todbot/sketchingpad/docs/planning.md

# sketchingpad_stripproto1

## pad layout from top

```
     17 18      19 20
 1  2  3  4    5  6  7  8
 9 10 11 12   13 14 15 16
 ```
 
 - flipped on horizontal axis (e.g. 1 & 9 mirrored)
 - dX = 18 mm
 - dY = 19 mm
 - midXfudge = 4mm (say)
 => `maxX = 4*dX + midXfudge = 4*18 + 10 = 82` 
 =>  22,40,58,76 for one side

## size
 180 mm x 62.4 mm   (7.1" x 2.5")  
 but want 6" (152mm, half = 152/2 = 76 mm

# NRF52840 links

- https://github.com/joric/nrfmicro/wiki/Alternatives
- https://github.com/joric/nrfmicro/wiki/Bootloader
- https://github.com/abulalarabi/NRF52-BRICKED
- https://docs.zephyrproject.org/latest/boards/others/promicro_nrf52840/doc/index.html
- https://nicekeyboards.com/docs/nice-nano/troubleshooting/
