todbot/sketchingpad/docs/artwork/waves-20260901-184750.png

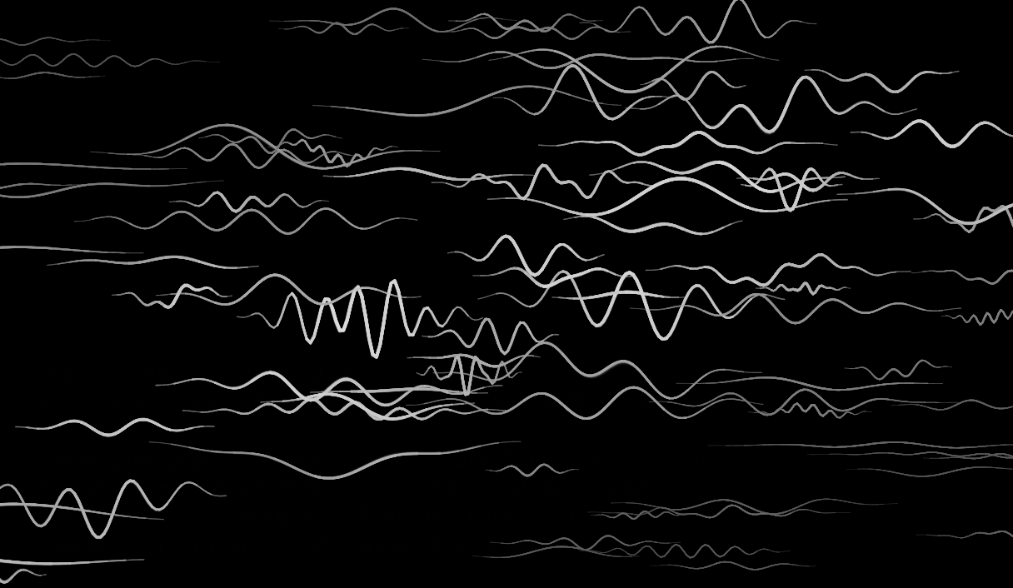
docs/artwork/waves-20260901-184750.png
