todbot/sketchingpad/docs/artwork/waves-20260901-184809.png

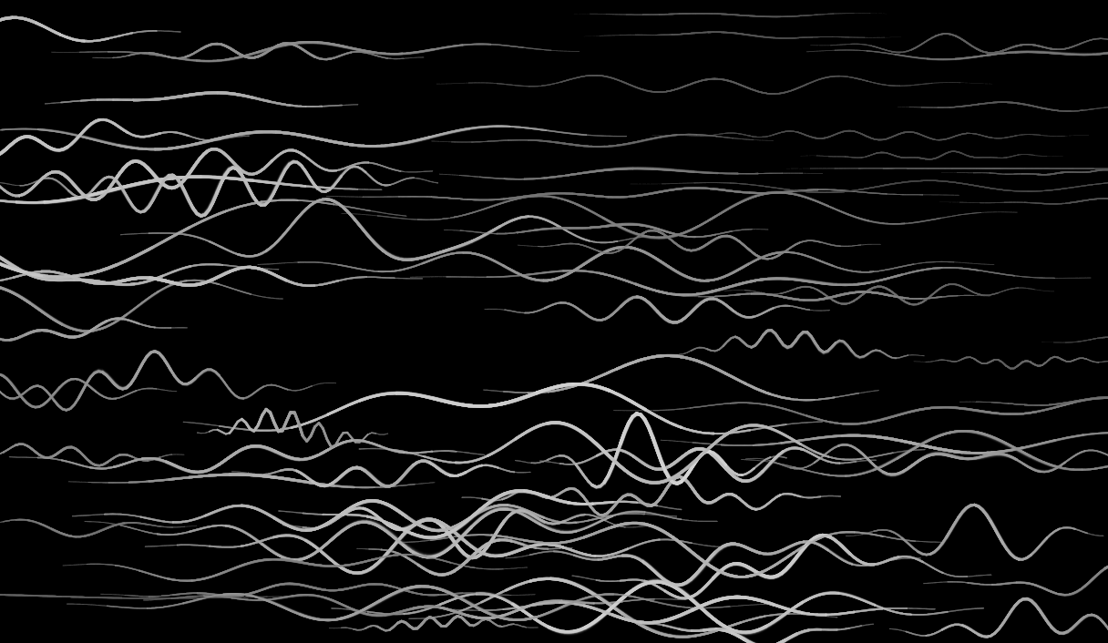
docs/artwork/waves-20260901-184809.png
