todbot/sketchingpad/docs/artwork/waves-20260901-184929.png

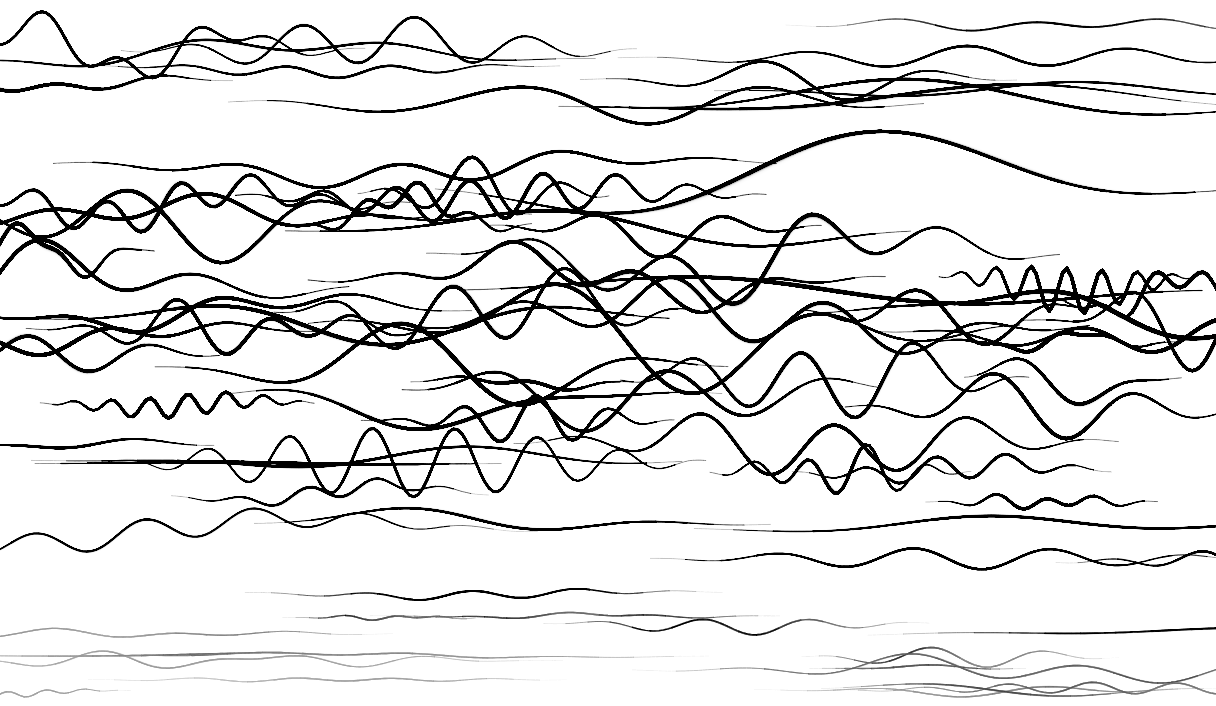
docs/artwork/waves-20260901-184929.png
