todbot/sketchingpad/docs/sketchingpad1-render.jpg

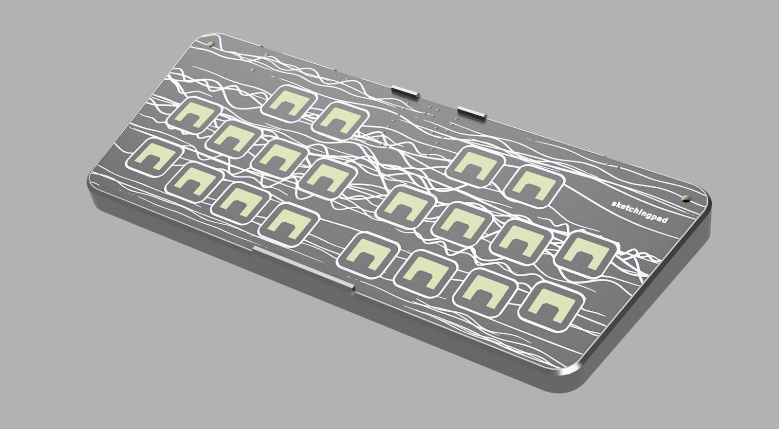
docs/sketchingpad1-render.jpg
