todbot/sketchingpad/enclosure/sketchingpad_case_soldered_sketching.stl

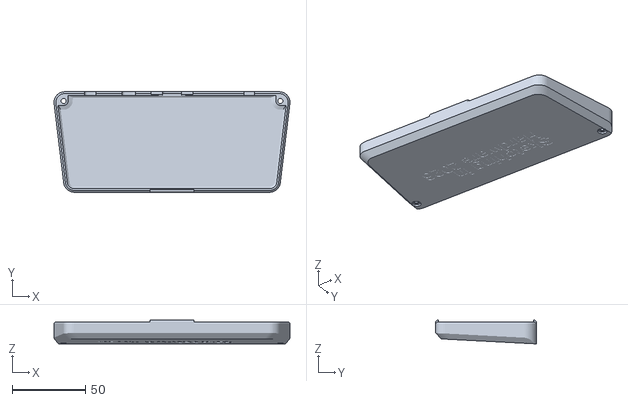
[picture p9: CAD file, 2026-10-23]
enclosure/sketchingpad_case_soldered_sketching.stl
161.1 x 68.7 x 16.2
