todbot/sketchingpad/(list of files, cad)

Other CAD files:
enclosure/sketchingpad_case_soldered.step
enclosure/sketchingpad_case_header.step
enclosure/sketchingpad_case.step
enclosure/sketchingpad_case.f3z
enclosure/sketchingpad_case_header.stl
enclosure/sketchingpad_case_soldered.stl
