todbot/sketchingpad/docs/issues.md

# Issues with sketchingpad pcb (aka sketchingpad_proto2)

- BAT+/BAT- pins cannot take the 9mm solderable pogo pins (they short)
- Instead: 50mm stranded wire pair soldered between PCB and XIAO NRF52840

# Issues with sketchingpad_proto1 pcb

- QTPy footprint flipped. omg duh
- Corner radii too small, looks weird
- Backlit LEDs do not show blue very well
