todbot/sketchingpad/schematics/sketchingpad1/sketchingpad1-sch.pdf

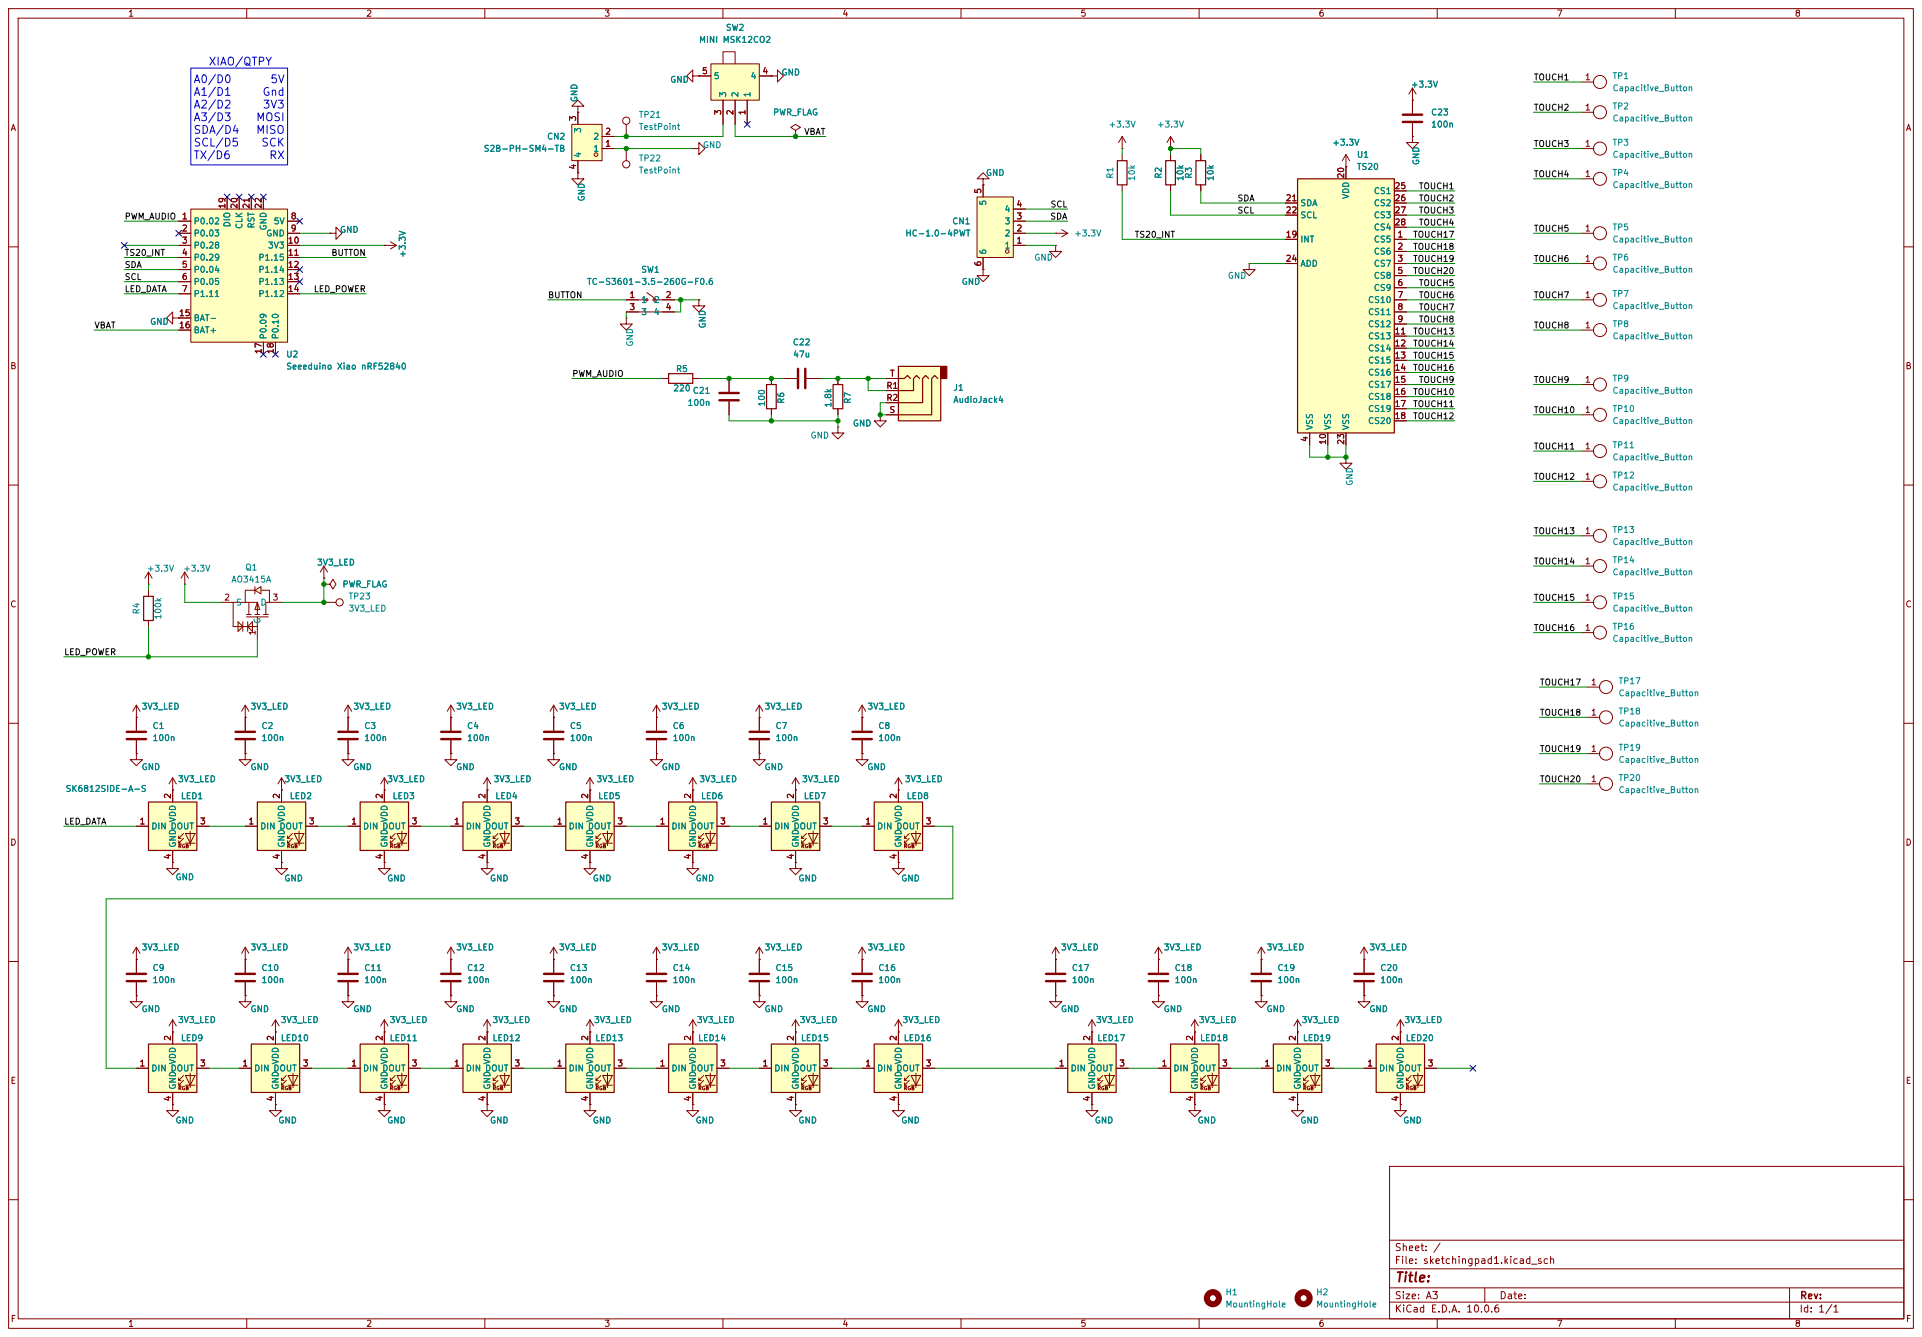
[picture p10: page 1]

Size: A3 | Rev: | F Date:
KiCad E.D.A. 10.0.6 | Id: 1/1
