todbot/sketchingpad/schematics/sketchingpad1_mpr/sketchingpad1_mpr-sch.pdf

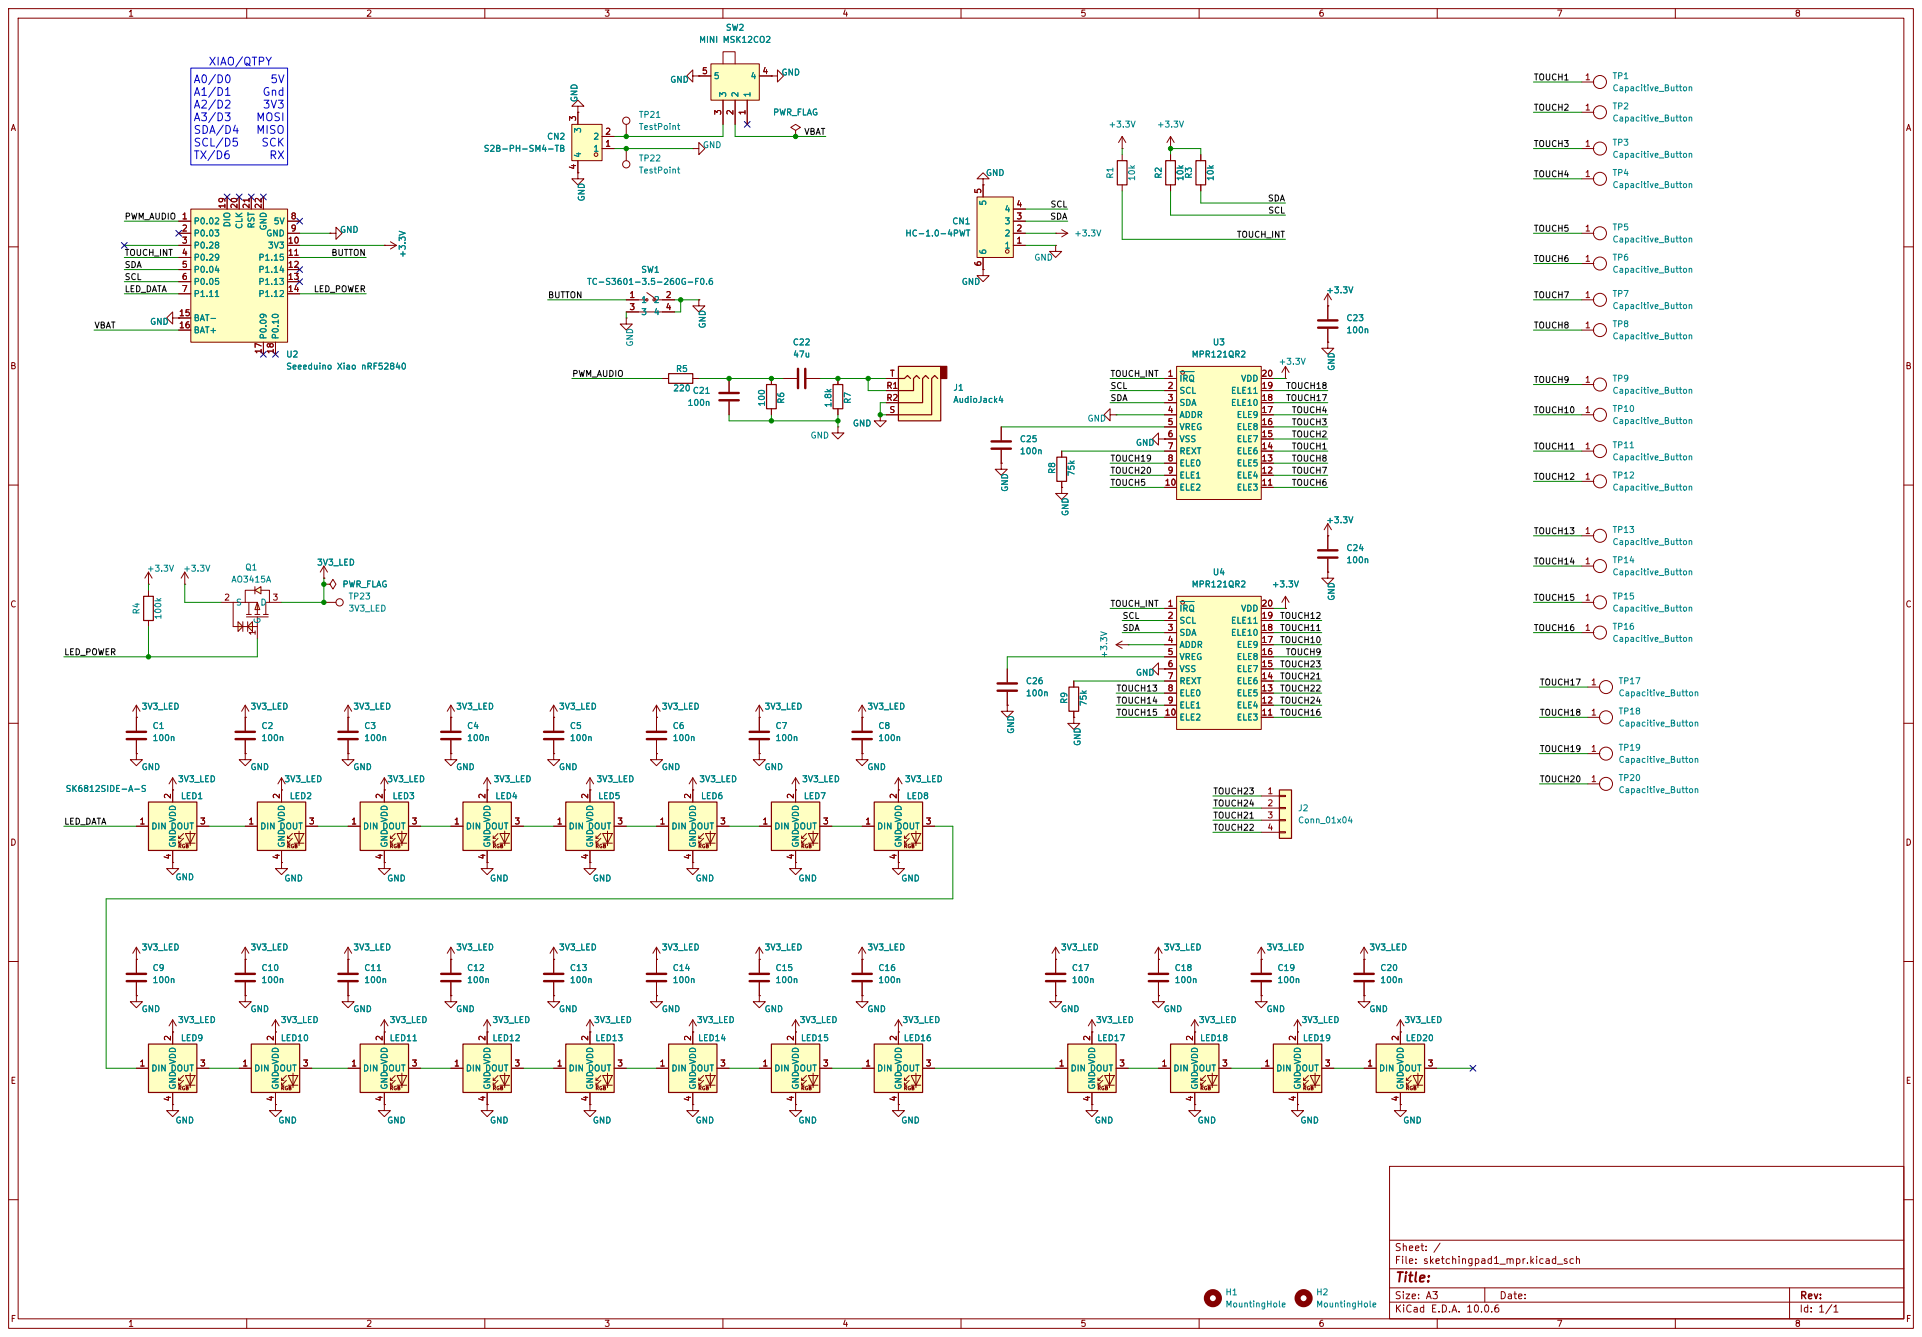
[picture p11: page 1]

Size: A3 | Rev: | F Date:
KiCad E.D.A. 10.0.6 | Id: 1/1
