todbot/sketchingpad/(commit log)

2026-07-03 some pcb layout for touch
    [leds.kicad_sch, sketchingpad.kicad_pcb, sketchingpad.kicad_sch]
2026-07-08 sketchingpad_proto1: chickening out with sk6812side instead of charlieplex RGB
    [leds.kicad_sch, sketchingpad.kicad_pcb, sketchingpad.kicad_sch, sketchingpad_proto1.kicad_pcb, sketchingpad_proto1.kicad_sch]
2026-07-09 sketchingpad_proto1: routing
    [sketchingpad_proto1.kicad_pcb]
2026-07-09 sketchingpad_proto1: routing done, no drc
    [leds.kicad_sch, sketchingpad_proto1.kicad_pcb]
2026-07-10 sketchingpad_proto1: routing cleanup, no drc
    [sketchingpad_proto1.kicad_pcb]
2026-07-20 add boost converter
    [sketchingpad_proto1.kicad_pcb, sketchingpad_proto1.kicad_sch]
2026-07-31 update boost converter parts
    [sketchingpad_proto1.kicad_pcb, sketchingpad_proto1.kicad_sch]
2026-07-31 extra input boost cap, stemmaqt/qwicc connector, added top decorative fill
    [leds.kicad_sch, sketchingpad_proto1.kicad_pcb, sketchingpad_proto1.kicad_sch]
2026-07-31 cleanup after some DRC/ERC
    [sketchingpad_proto1.kicad_pcb, sketchingpad_proto1.kicad_sch]
2026-08-25 circuitpytohn tests
2026-08-29 add stripproto1
    [sketchingpad_stripproto1.kicad_pcb, sketchingpad_stripproto1.kicad_sch]
2026-08-30 add arduino hwtest
    [sketchingpad_stripproto1.kicad_pcb, sketchingpad_stripproto1.kicad_sch]
2026-08-30 add circuitpython pwm audio test on nrf52
2026-08-30 add ble_keyboard_lowpower and start and group BLE party
    [sketchingpad_stripproto1.kicad_sch]
2026-08-30 going with SMD-mounted XIAO I guess, added audio. ERC clean
    [sketchingpad_stripproto1.kicad_pcb, sketchingpad_stripproto1.kicad_sch]
2026-08-30 final on the sketchingpad_stripproto1 sch maybe
    [sketchingpad_stripproto1.kicad_pcb, sketchingpad_stripproto1.kicad_sch]
2026-08-31 more routed
    [sketchingpad_stripproto1.kicad_pcb, sketchingpad_stripproto1.kicad_sch]
2026-08-31 0 unrouted. DRC is a mess tho
    [sketchingpad_stripproto1.kicad_pcb]
2026-08-31 DRC better
    [sketchingpad_stripproto1.kicad_pcb]
2026-08-31 ERC and DRC pass
    [sketchingpad_stripproto1.kicad_pcb, sketchingpad_stripproto1.kicad_sch]
2026-08-31 sketchingpad_stripproto1 is now sketchingpad_proto2
    [sketchingpad_proto2.kicad_pcb, sketchingpad_proto2.kicad_sch]
2026-09-02 front silk maybe
    [sketchingpad_proto2.kicad_pcb]
2026-09-02 sketchingpad_proto2 sent to jlc
    [sketchingpad_proto2.kicad_pcb]
2026-09-03 rework ble device id stuff
    [ble_broadcast.ino, ble_keyboard_simple.ino, device_id_code.h]
2026-09-03 add arduino readme & notes
2026-09-03 circuitpython low-power work
2026-09-04 add radio antennae keepout, oops
    [sketchingpad_proto2.kicad_pcb]
2026-09-16 add LED_POWER_PIN to hwtest arduino exmamples, add device_id test
2026-09-16 fix arduino led_to_pad mapping for proto2 board
    [ble_broadcast_anim.ino, ble_keyboard_lowpower.ino, ble_keyboard_simple.ino, hwtest_ts20.ino]
2026-09-16 update arduino README
2026-09-16 update circuitpython tests for proto2 pinout
2026-09-17 move old sch out of the way
    [leds.kicad_sch, sketchingpad_idea1.kicad_pcb, sketchingpad_idea1.kicad_sch]
2026-09-17 sketchingpad1 is final pcb I guess
    [sketchingpad1.kicad_pcb, sketchingpad1.kicad_sch]
2026-09-17 sketchingpad1 (nee sketchingpad_proto2) small silkscreen adjust before production
    [sketchingpad1.kicad_pcb]
2026-09-17 crap, TS20 out of stock at LCSC. respin with 2xMPR121
    [sketchingpad1_mpr.kicad_pcb, sketchingpad1_mpr.kicad_sch]
2026-09-17 routed. crap, TS20 out of stock at LCSC. respin with 2xMPR121
    [sketchingpad1_mpr.kicad_pcb, sketchingpad1_mpr.kicad_sch]
2026-09-18 fix 75->75k mpr resistors. routed. crap, TS20 out of stock at LCSC. respin with 2xMPR121
    [sketchingpad1_mpr.kicad_sch]
2026-09-18 sketchingpad1_mpr: small header for unused touch pins
    [sketchingpad1_mpr.kicad_pcb, sketchingpad1_mpr.kicad_sch]
2026-09-18 working on dual-function code that works with TS20 and MPR121 versions of the board, whichever I get done first
    [sketchingpad1_mpr.kicad_pcb]
2026-09-18 rearrange arduino directory
2026-09-18 multi-board version of ble_broadcast_anim
2026-09-26 add enclosure first cut
    [sketchingpad_case.f3z, sketchingpad_case.step, sketchingpad_case.stl]
2026-09-26 add simple button test to arduino hwtest_touch
2026-09-26 note battery wiring issues. sigh
2026-09-26 cleanup and update readme
    [leds.kicad_sch, sketchingpad_idea1.kicad_pcb, sketchingpad_idea1.kicad_sch, sketchingpad_proto1.kicad_pcb, sketchingpad_proto1.kicad_sch, sketchingpad_proto2.kicad_pcb, sketchingpad_proto2.kicad_sch, sketchingpad_stripproto1.kicad_pcb]
2026-09-27 add arduino ble_keyboard_simple that should work on both boards
2026-09-28 add sketchingpad_midi_simple on both Arduino and CircuitPython
2026-09-28 update circuitpython ble_keyboard_lowpower
2026-09-28 add fix for arduino sketchingpad_midi_simple, to get around that Seeed has really old Adafruit_TinyUSB library
    [copies_test.py, sketchingpad_midi_simple.ino]
2026-09-30 add serial startup pause to hwtest_touch arduino
2026-10-01 update case: pcb shelf embiggen and fillets
    [sketchingpad_case.f3z, sketchingpad_case.step, sketchingpad_case.stl]
2026-10-01 fix ble_broadcast_anim bugs, hopefully
    [anim_wire.h, ble_broadcast_anim.ino, device_id_code.h, led_anim.h]
2026-10-02 enclosure updates
    [sketchingpad_case.f3z, sketchingpad_case.stl, sketchingpad_case_header.step, sketchingpad_case_header.stl, sketchingpad_case_soldered.step, sketchingpad_case_soldered.stl]
2026-10-02 add arduino ble_keyboard_lowpower
2026-10-04 arduino Makefile: add make flash target
2026-10-05 update enclosure
    [sketchingpad_case.f3z]
2026-10-13 Add link for case install/removal instructions
    Added a link for case installation and removal instructions.
2026-10-17 update board desc image
2026-10-23 added circuitpython and audio tests. oof audio sounds bad on this board
    [sketchingpad_case_soldered_sketching.stl]
2026-10-23 update cirpy swarmsynth, still too noisy because of LED PWM
2026-10-23 fix CI for circuitpython builds
    [uf2_to_hex.py]
2026-10-29 add sketchingpad_gamepad arduino
